dsstutts/ATMC/Schematics/ATMC_schem2.pdf

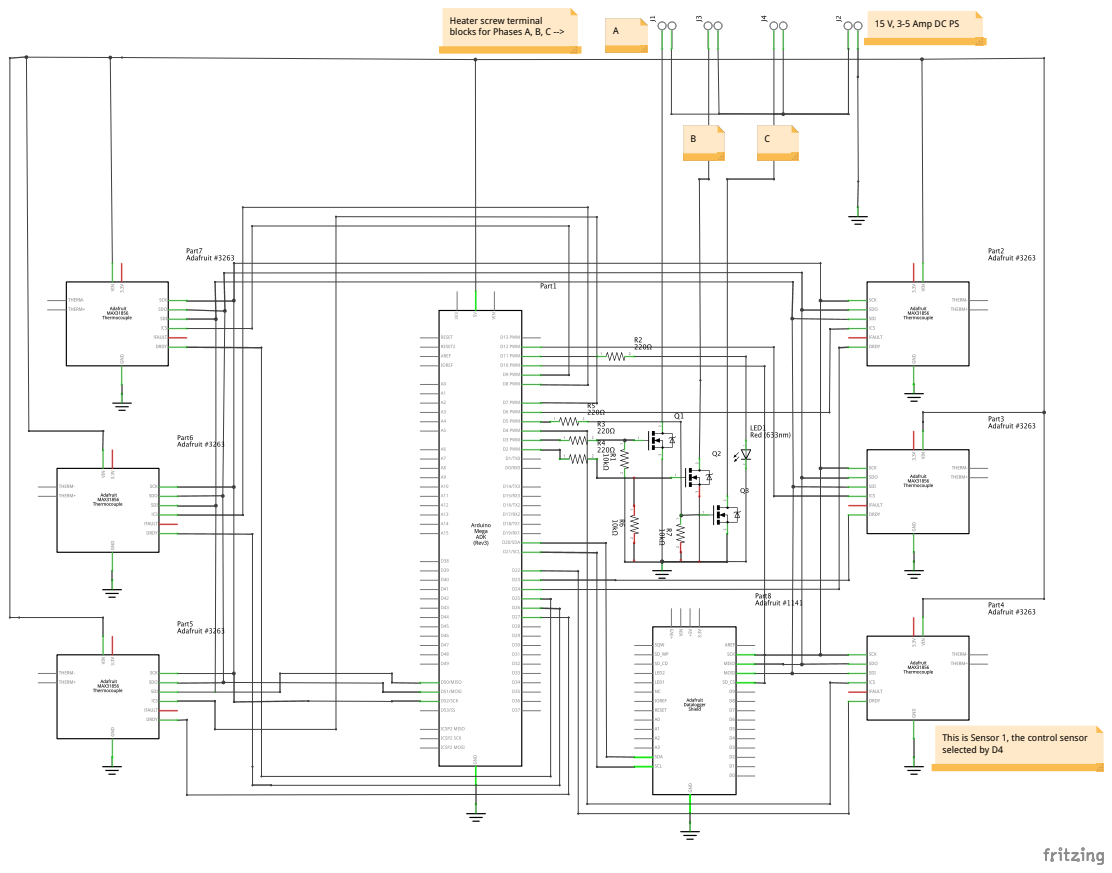
[picture p1: page 1]

Heater screw terminal
blocks for Phases A, B, C -->

15 V, 3-5 Amp DC PS

This is Sensor 1, the control sensor
selected by D4
