dsstutts/ATMC/Schematics/ATMC_schem.pdf

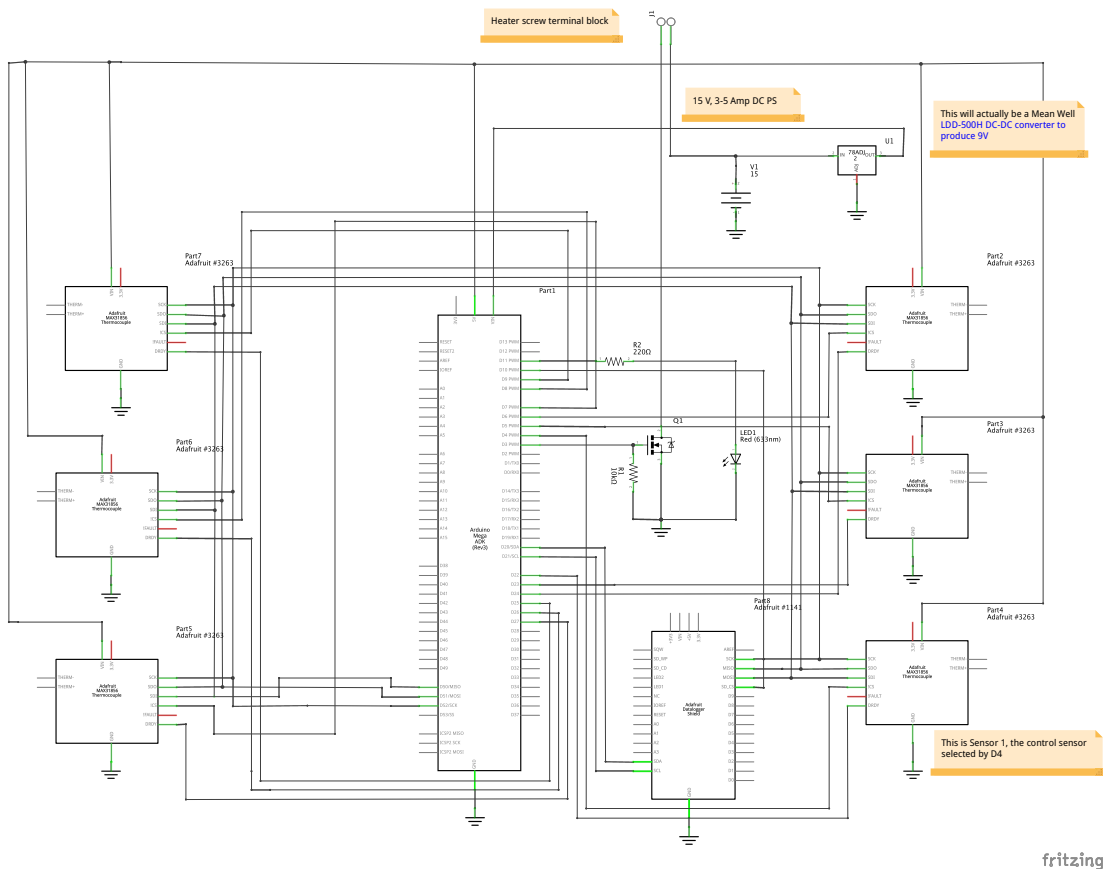
[picture p2: page 1]

Heater screw terminal block

15 V, 3-5 Amp DC PS

This will actually be a Mean Well
LDD-500H DC-DC converter to
produce 9V

This is Sensor 1, the control sensor
selected by D4
