dsstutts/ATMC/(commit log)

2017-02-15 Slowed down baud rate to 250k, and fixed MAX31856 chip select settings.
    [ATMC.ino]
2017-02-17 Removed the inexplicable if(i = 1)Interval = (unsigned int)atoi(dataStr);//Prevent invalid intervals. statement in the parser. I don’t know what I was thinking when I wrote that… Also removed some de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
    [ATMC.ino]
2017-02-18 Added temps 3 through 6 to the SD storage string. Found out that the TCs have to be electrically insulated from the metal rods during heating, or they quit sending new temperatures — only the last va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
    [ATMC.ino]
2017-04-21 Added year, month, day setting, and fixed a few errors.
    [ATMC.ino]
2017-04-21 Now prints out and stores current integer duty cycle. The maximum is 1023 (10 bits).
2017-04-23 Consolidated the if ‘C’ duty cycle setting command, and added the W command to simultaneously set the duty cycle and start logging data. Also set readTemp = true when in openLoop, to trap over-temper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
2017-04-23 Increased the maximum (before shutdown) temperature to 120 degrees C to facilitate constant input power cases.
2017-06-19 Added data sheets and schematics to repo for convenience.
2017-08-11 Completed the current help string, and modified the Read Me accordingly.
2017-09-23 Fixed broken temperature control option by adding controlOn = true in A (acquire data and control temp) option in parser.
    [ATMC.ino]
2017-11-17 Forgot to empty dcStr buffer -- fixed now.
    [ATMC.ino]
2017-11-22 Implemented setting non-default target temperature. Added a few more return statements to the parser -- no point in hanging around once the job is done! Corrected over-temp shutdown comment in main l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
    [ATMC.ino]
2017-11-26 Added optional functionality to control a Peltier device for both heating and cooling via an H-bridge. The option is selected using the conditional compile pragma: #define HBRIDGE 1. Handled invalid 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
2017-11-26 Added comments about the new HBRIDGE pragma and functionality, and reset HBRIDGE to 0 as the default.
    [ATMC.ino]
2017-11-26 Added a second NOP to the H-bridge driver code because the total turn-off time of the logic-level MOSFET we are using is about 100 ns, so two NOPs at 62.5 ns each yields 125 ns of dead time -- which 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
2017-11-27 Added more comments and corrected pre-compiler directives. It turns out that it is sufficient to simply #define directive and not use #define directive 1, so simply commenting the directives out remo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
    [ATMC.ino]
2017-11-30 Added the option to control three temperatures using the pre-compiler directive THREEPHASE. The THREEPHASE option uses all three of the Timer3 PWM channels. Also had to #define SINGLEPHASE to control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
2017-11-30 Added #defines for PWM_PIN_C, and REV1 which will change the pin assignment for MAX31856_CS2 from Pin5 to Pin12 because we need Pin5 for the Phase C PWM output. Restructured some ifdef/else/elif pre-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
2017-12-04 Added correct CS assignments for the version 1.0 prototype having only two TCs.
    [ATMC.ino]
2017-12-04 Added open loop control of fan speed via f# using phase B PWM out.
2017-12-04 Switched fan speed setting to the Phase C PWM output to avoid conflicting with the H-bridge option -- in case we want to also control a fan while using the H-bridge.
    [ATMC.ino]
2017-12-06 Added threephaseTC Arduino sketch to simultaneously control three temperatures. This is a stripped-down version of ATMC to simplify debugging and development. It currently has superfluous command lin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
2017-12-08 Added H-bridge-specific code, which is 'mostly' functional, but needs more testing ensure sufficient phase switching dead time. It also looks like we'll need to add H-bridge drivers to fully switch t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
    [ATMC_Hbridge.ino]
2017-12-08 Fixed initial update setting: - Timer1.initialize(((long)updateIntervals[1]) * 1000); // Set default update interval. + Timer1.initialize(((long)updateIntervals[Interval]) * 1000); // Set default upd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
    Cooked the MOSFET drivers during testing, however...
    [ATMC_Hbridge.ino]
2017-12-11 Slowed down Timer3 PWM frequency from 25 kHz to 2.5 kHz to reduce switching frequency. Timer3.initialize(400); // 40 us => 25 kHz PWM frequency 400->2.5kHz.
2018-01-10 Added version string for output file in ATMC, and cleaned up help string a bit. Removed some unneeded print statements in H-bridge verison.
2018-01-25 Fixed parser logic error in update rate setting and and option 'f'. Still need to fix long term update rates such as 60 seconds... Added control update error trap since 60 seconds would be too long t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
    [ATMC.ino]
2018-01-26 Added a 4 second update period, which corresponds to the longest possible Timer1 integer interval interrupt. The maximum period using the 1024 prescaler is 4.194304 seconds.
2018-05-02 Switched back to 250k baud serial.
2018-05-02 We're not using TimerFive.
2018-05-03 Partial update of threephaseTC, and typo fix in ATMC three-phase PID control section.
    [ATMC.ino, threephaseTC.ino]
2018-06-02 Update README.md
    Modified to reflect the new three phase temperature control branch.
2018-07-11 Removed erroneous local setTemp declaration in parser. This prevented the T set temperature function from working...
    [ATMC.ino]
2018-07-13 Removed erroneous local setTemp declaration in parser. This prevented the T set temperature function from working...
    [threephaseTC.ino]
2019-01-04 Added command (q#) to only set the boundary temperature, but not turn power on or record data which is done using the 'A' command.
2019-04-01 Changed some #elifdef statements to the correct to #elif.
    [ATMC.ino]
2019-09-10 simplified code to test new board.
2019-09-11 Removed use of LED
2019-09-30 Chip Selects for new board and slower speed.
2019-10-17 fixed issues with card initialization
    [AMTC_NewBoardV2.ino]
2020-01-14 Code works on new board. Saves thermocouple data, iDC, then cold junction data to SD card. Can adjust cold junction compensation and change which thermocouples are reading. Also has dataready functio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
2020-11-28 Added the current help string to the ReadMe as a place holder. Changed MAXFILES from 2000 to the actual current limit of 99.
2023-04-23 This is a simplified version of ATMC.ino with reduced functionality. It can set the duty cycle, change data acquisition rate, print the help string, acquire data with or without power, and stop and s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
2023-05-02 Corrected .setPwmDuty call, and removed debugging comments on save data and create file.
    [ATMC_SixTCBoard_SimplifiedCode.ino]
2023-12-01 Fixed incorrect function call to set PWM duty cycle. It was Timer3.setPwmDuty(), but the correct call is: Timer3.pwm(). Also added serial output of the setting, and a few more Serial.print statements.
    [ATMC_SixTCBoard_SimplifiedCode.ino]
2025-10-27 First commit of new Python analysis code, and updated Arduino code.
2025-10-28 Fixed main model plot naming and set material to Al = True. Will provide example data file.
    [mph_Estimator.py]
2025-10-28 Added example CSV data file, al300test.csv
    [al300test.csv]
2026-04-28 Fixed s option logic error in ATMC.ino and harmonic_boundary_heating.ino, and added a few more comments in the latter.
    [ATMC.ino, harmonic_boundary_heating.ino]
2026-04-28 Added ATMC_SixTCBoard_PortableOptimized_RTC_Versioned.ino which is a significantly revised and enhanced version of ATMC_SixTCBoard_SimplifiedCode.ino adding portability across the Arduino ecosystem, 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
2026-04-30 Fixed s option bug in ATMC_SixTCBoard_SimplifiedCode.ino. Added TransientMethodParameterEstimationCode/oneDkhEstimator.py and data/ directory containing sample data. Revised main README.md, and added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
    [ATMC_SixTCBoard.ino]
2026-05-01 Added w#### to step-change the duty cycle. This is primarily for w0 to turn the heater off and allow cooling. Generalized EEPROM storage and retrieval of data acquisition rate setting.
